lxw111110/MyMiniFly/hardware/mini_fly/Project Outputs for mini_fly/four_axis_v1.xls

Item # | #Column Name Error:Manufacturer | #Column Name Error:Manufacturer No | Quantity | #Column Name Error:Note | Designator | Description | Footprint | Comment | LibRef
1 |  |  | 1 |  | C1 |  | 0603P | 2.2pf | C
2 |  |  | 1 |  | C2 |  | 0603P | 2.2nf | C
3 |  |  | 1 |  | C3 |  | 0603P | 0.047uf | C
4 |  |  | 7 |  | C4, C13, C18, C19, C22, C27, C30 |  | 0603P | 10uF | C
5 |  |  | 3 |  | C5, C21, C28 |  | 0603P | 10nf | C
6 |  |  | 1 |  | C6 |  | 0603P | 220pf | C
7 |  |  | 13 |  | C7, C11, C12, C14, C15, C16, C17, C20, C23, C24, C29, C31, C32 |  | 0603P | 0.1uf | C
8 |  |  | 2 |  | C8, C9 |  | 0603P | 12pf | C
9 |  |  | 2 |  | C10, C26 |  | 0603P | 1uF | C
10 |  |  | 1 |  | C25 |  | C0805 钽电容 | 22uF | CAP
11 |  |  | 2 |  | D1, D2 | LED 1206 侧贴 双色 | LED1206 侧贴 | LED-RG | LED 1206 侧贴 双色
12 |  |  | 2 |  | D3, D4 | LED 1206 侧贴 单色 | LED1206 侧贴 | LED-B | LED 1206 侧贴 单色
13 |  |  | 4 |  | D5, D6, D7, D8 | 单肖特基二极管 | SOD-323 | BAT54WS | BAT54
14 |  |  | 1 |  | L1 |  | 0603P | 3.9nH | L
15 |  |  | 1 |  | L2 |  | 0603P | 1nH | L
16 |  |  | 1 |  | L3 |  | 0603P | 1uH | L
17 |  |  | 4 |  | MOS1, MOS2, MOS3, MOS4 | AP2306 | SO-G3/C2.5 | SI2302 | MOS-N
18 |  |  | 1 |  | P1 |  | SH1.0-6P | STM_SWD | HEAD6
19 |  |  | 1 |  | P2 |  | HEADER8-2.0MM | CONN_8_RIGHT | HEAD8
20 |  |  | 1 |  | P3 |  | HEADER8-2.0MM | CONN_8_LEFT | HEAD8
21 |  |  | 1 |  | P4 | Header, 2-Pin | HDR1X2 | Battery | Header 2
22 |  |  | 1 |  | P5 |  | MICRO_USB5P_SOP | MICRO-USB | USB5
23 |  |  | 4 |  | P6, P7, P8, P9 |  | HEADER2-1.25MM | HEAD2 | HEAD2
24 |  |  | 5 |  | R1, R2, R3, R4, R28 |  | 0402 | 51R | R
25 |  |  | 2 |  | R5, R6 |  | 0402 | 1K | R
26 |  |  | 7 |  | R7, R8, R11, R12, R17, R21, R23 |  | 0402 | 10K | R
27 |  |  | 4 |  | R9, R10, R20, R22 |  | 0402 | 100R | R
28 |  |  | 5 |  | R13, R18, R19, R25, R26 |  | 0402 | 4.7K | R
29 |  |  | 1 |  | R14 |  | 0402 | 0R | R
30 |  |  | 2 |  | R15, R16 |  | 0402 | 49.9K | R
31 |  |  | 1 |  | R24 |  | 0402 | 510R | R
32 |  |  | 1 |  | R27 |  | 0402 | 100K | R
33 |  |  | 1 |  | R29 |  | 0402 | 1.6K | R
34 |  |  | 1 |  | SW1 |  | KEY_2S | SW_PUSH | KEY
35 |  |  | 1 |  | U1 |  | QFN16M | RFX2401C | RFX2401C
36 |  |  | 1 |  | U2 |  | 0603-6 | 2450BM14A0002 | BALUN
37 |  |  | 1 |  | U3 |  | QFN48M-04 | NRF51822 | NRF51822
38 |  |  | 2 |  | U4, U6 |  | SOT23-5S | XC6204-30 | XC6204
39 |  |  | 1 |  | U5 | STM32411xC_xE | UFQFPN48 | STM32411CE | STM32F411xC_xE
40 |  |  | 1 |  | U7 | TP4059 | SOT23-6S | TP4059 | TP4059
41 |  |  | 1 |  | U8 |  | LGA-8 | BMP280 | BMP280
42 |  |  | 1 |  | U9 |  | QFN24-0.4 | MPU9250 | MPU9250
43 |  |  | 1 |  | X1 | 无源贴片晶振 | XTAL3225 无源 | 16MHz | XTAL-无源贴片
44 |  |  | 1 |  | X2 |  | XTAL3215 | 8MHz | XTAL-3215
45 |  |  | 1 |  | Y1 |  | 1206 | 2450AT18B100 | CHIP_ANTENNA
