lxw111110/MyMiniFly/structure/装配体2.SLDASM

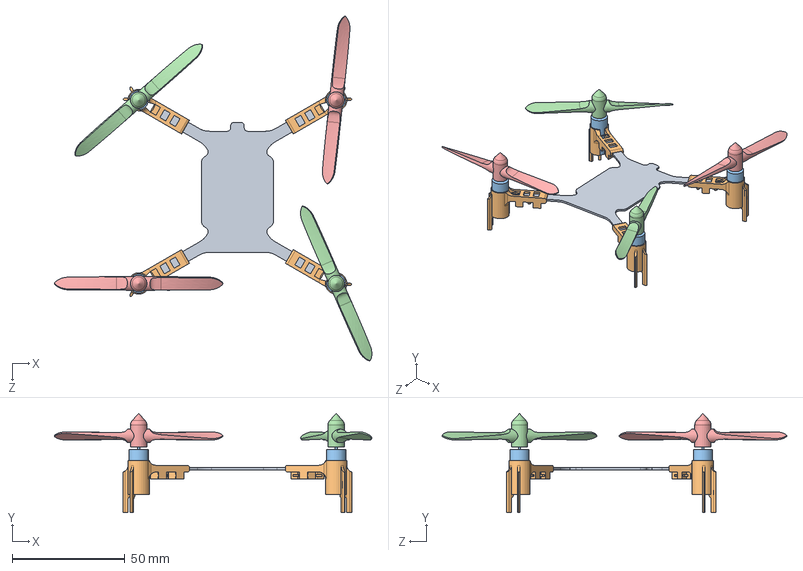
[picture p37: CAD file, 2018-09-06]
structure/装配体2.SLDASM
140.9 x 44.0 x 153.0 mm
airplane
支架 x 4
820电机 x 4
反浆 x 2
正浆 x 2
