lxw111110/MyMiniFly/structure/遥控器主板.SLDPRT

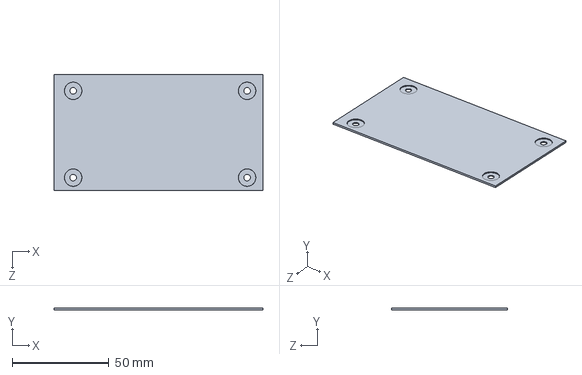
[picture p38: CAD file, 2018-10-11]
structure/遥控器主板.SLDPRT
108.0 x 1.00 x 60.0 mm
