lxw111110/MyMiniFly/structure/正浆.SLDPRT

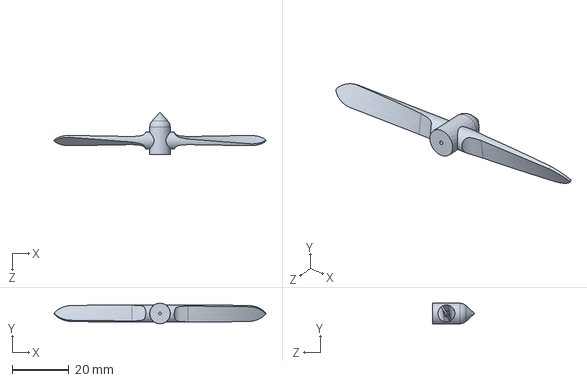
[picture p39: CAD file, 2018-09-06]
structure/正浆.SLDPRT
75.0 x 7.30 x 15.0 mm
