lxw111110/MyMiniFly/structure/airplane v1.0.DXF

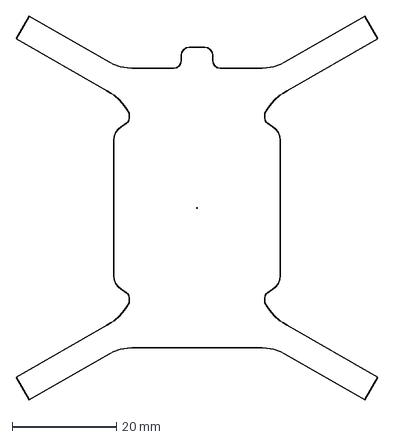
[picture p40: CAD file, 2018-09-06]
structure/airplane v1.0.DXF
69.3 x 73.7 mm
