lxw111110/MyMiniFly/structure/airplane.SLDPRT

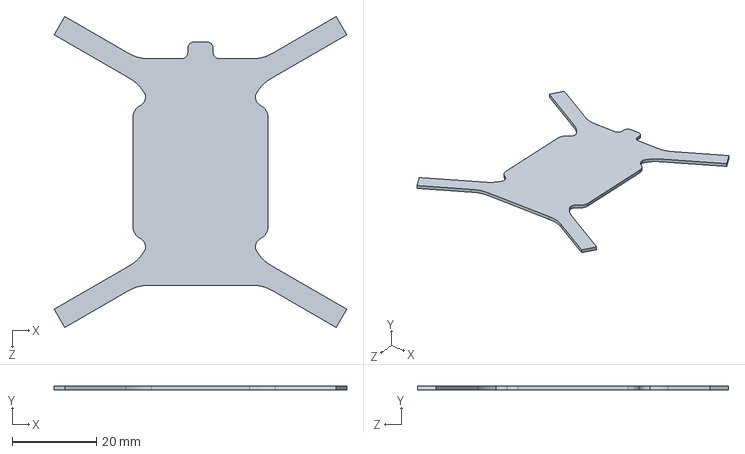
[picture p41: CAD file, 2018-09-06]
structure/airplane.SLDPRT
69.3 x 1.00 x 73.7 mm
