lxw111110/MyMiniFly/structure/支架.SLDPRT

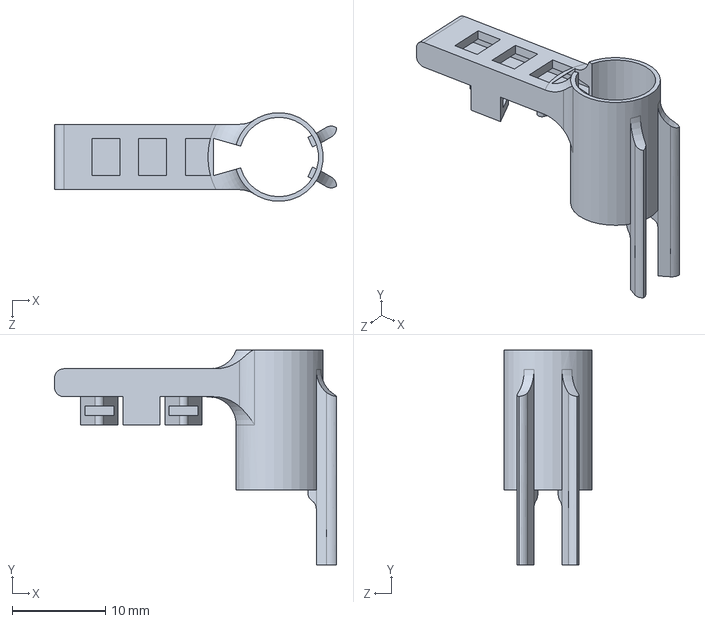
[picture p42: CAD file, 2018-09-06]
structure/支架.SLDPRT
30.2 x 23.0 x 9.46 mm
