lxw111110/MyMiniFly/structure/820电机.SLDPRT

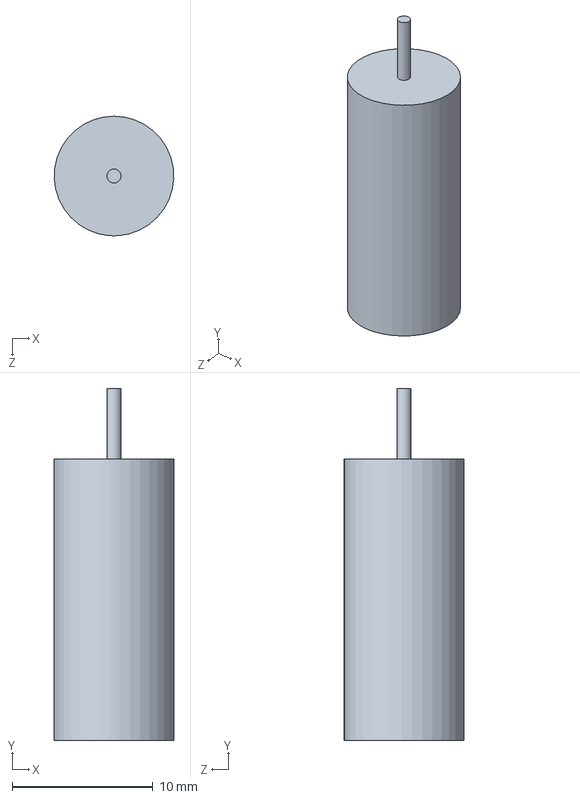
[picture p43: CAD file, 2018-09-06]
structure/820电机.SLDPRT
8.49 x 25.0 x 8.50 mm
