lxw111110/MyMiniFly/(list of files, cad)

Other CAD files:
structure/反浆.SLDPRT
structure/旋翼.SLDPRT
