lxw111110/MyMiniFly/doc/MiniFly V1.32.pdf

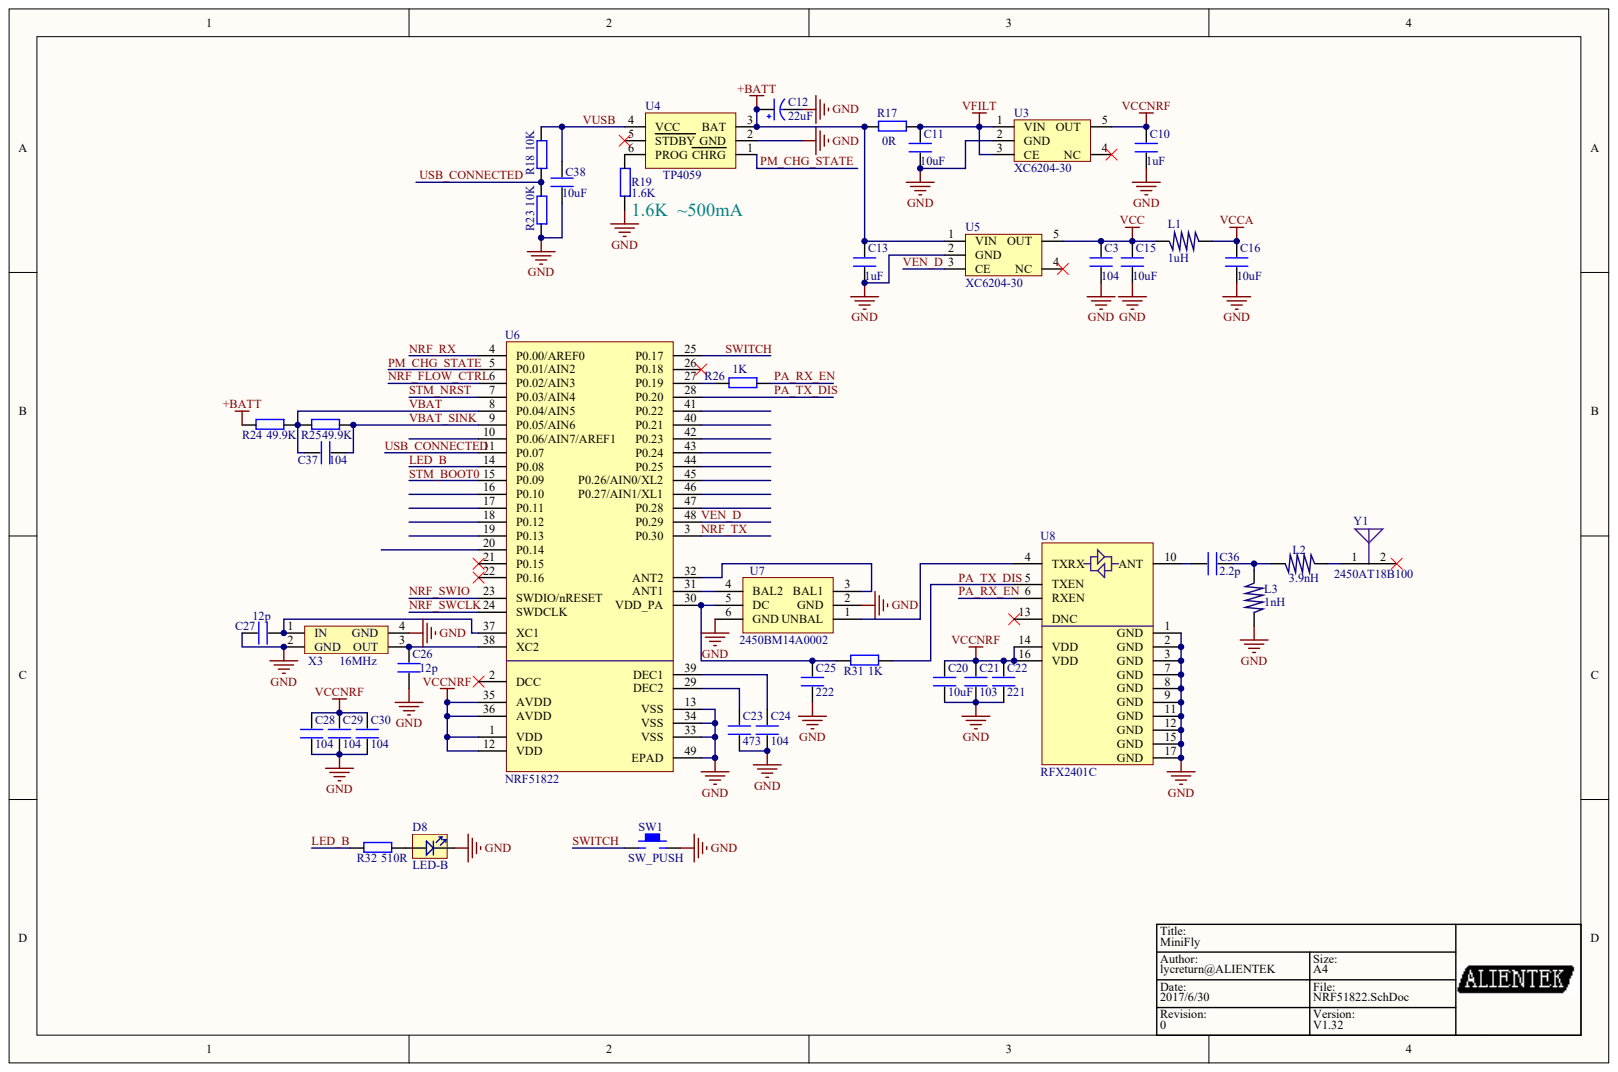
[picture p44: page 1]

PROG 6 | 10uF

PM_CHG_STATE

P0.05/AIN6 9
P0.06/AIN7/AREF1 10

TXRX 4

PA_RX_EN GND | RXEN 6 DNC 13

GND 6

VCCNRF

Title: MiniFly

Author: lycreturn@ALIENTEK | Size: A4

Date: 2017/6/30 | File: NRF51822.SchDoc

Revision: 0 | Version: V1.32

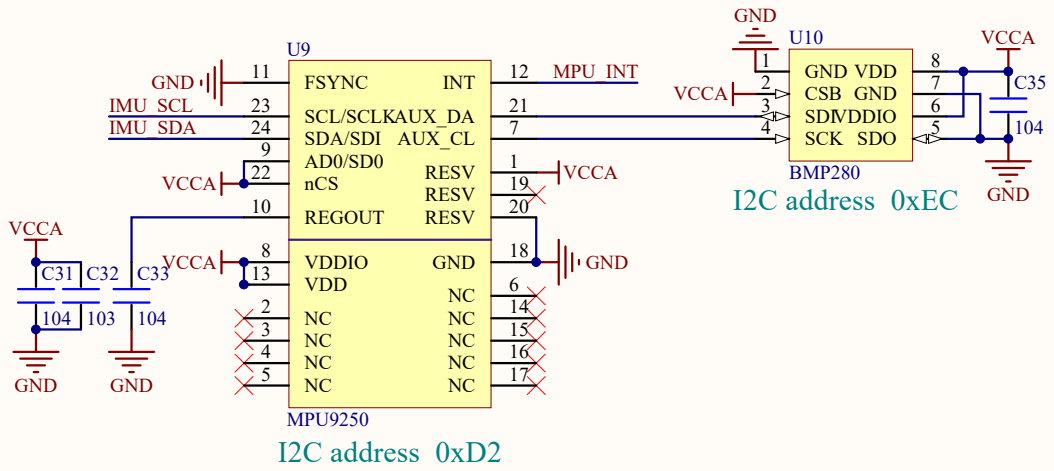
[picture p45: page 2]

Title : MiniFly

Author: lycreturn@ALIENTEK | Size: A4

Date : 2017/6/30 0 | File: SENSORS.SchDoc

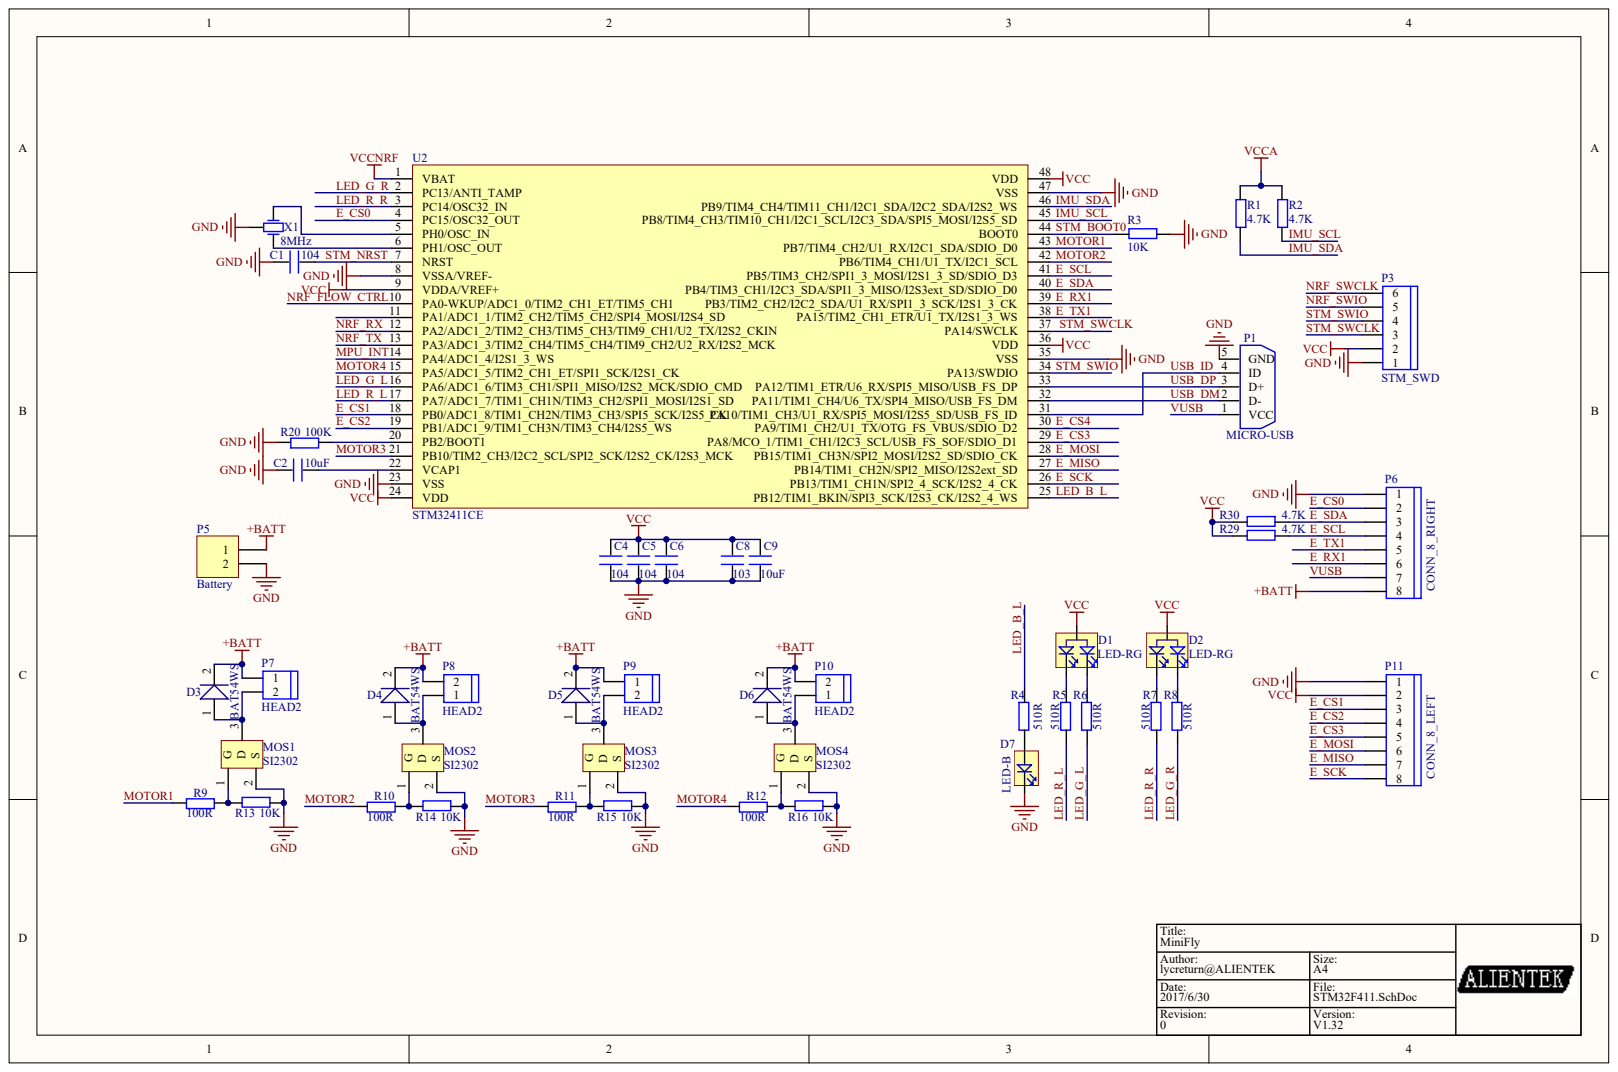
[picture p46: page 3]

E_CS0 | 4 | IMU_SCL

5 | STM_BOOT0R3

8MHz 6 | | MOTOR1

PA6/ADC1_6/TIM3_CH1/SPI1_MISO/I2S2_MCK/SDIO_CMD 16 | USB_DP
PA7/ADC1_7/TIM1_CH1N/TIM3_CH2/SPI1_MOSI/I2S1_SD 17 | USB_DM
PB0/ADC1_8/TIM1_CH2N/TIM3_CH3/SPI5_SCK/I2S5_CK 18 | VUS B

Title : MiniFly

Author: lycreturn@ALIENTEK | Size: A4

Date : 2017/6/30 0 | File: STM32F411.SchDoc

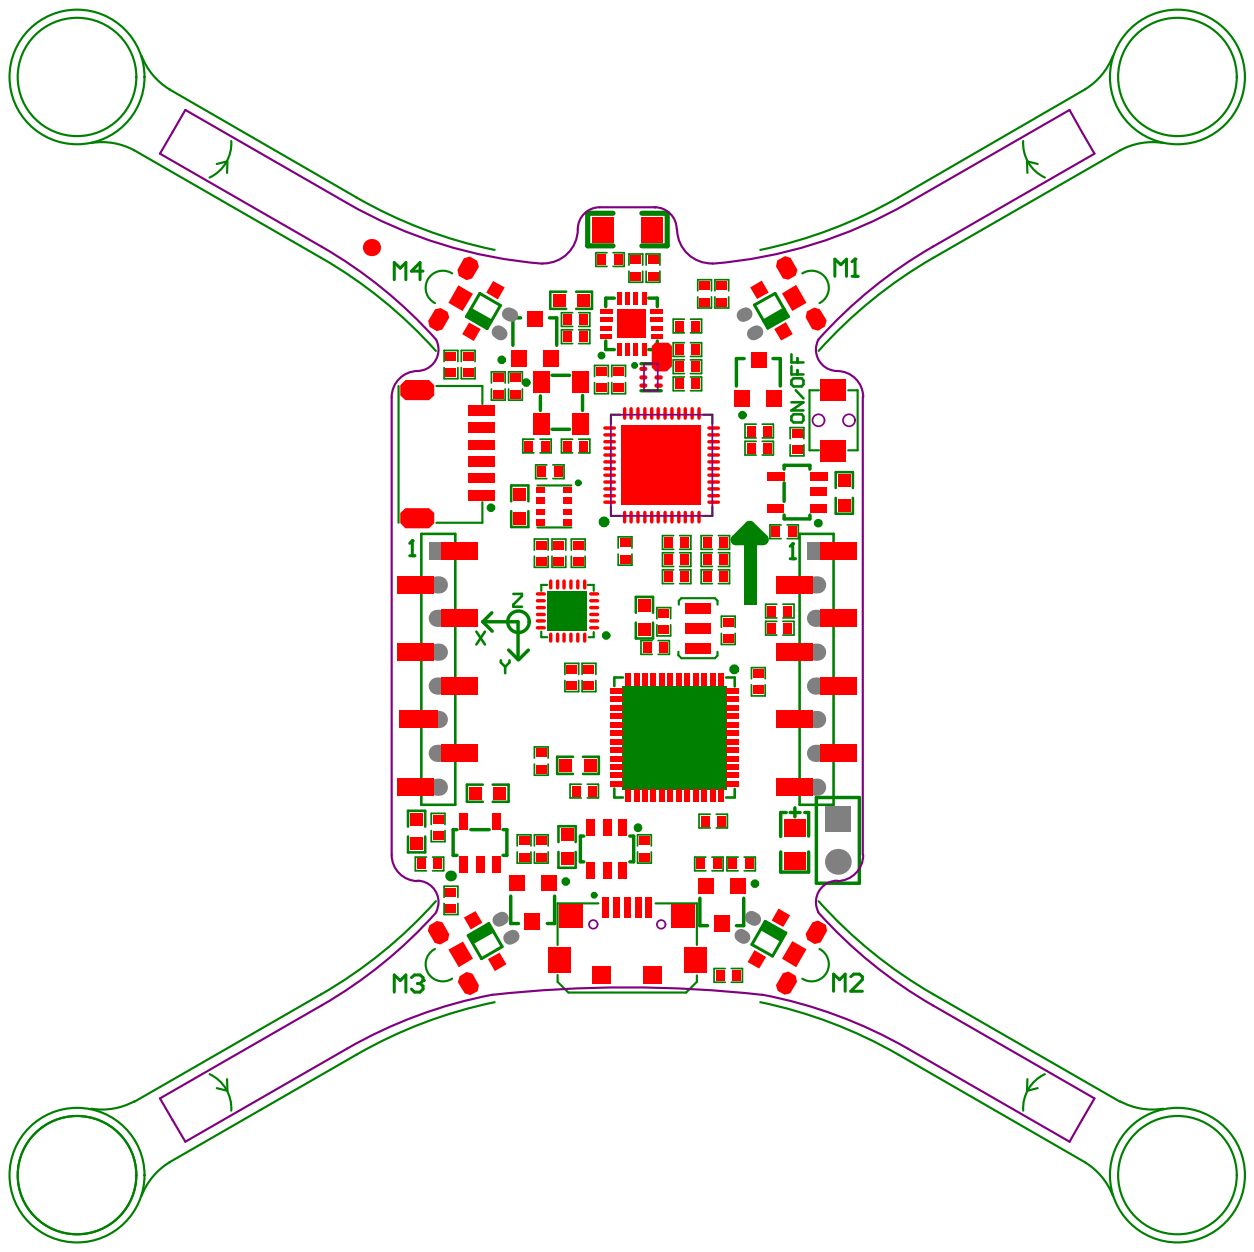
[picture p47: page 4]
