lxw111110/MyMiniFly/(list of files, drawings)

Other design files:
hardware/mini_fly/four_axis_part1.SchDoc
hardware/mini_fly/four_axis_part2.SchDoc
hardware/mini_fly/four_axis_part3.SchDoc
hardware/mini_fly/mini_fly.PrjPcb
