lxw111110/MyMiniFly/(commit log)

2018-09-06 MyMiniFly 基础结构与硬件文件
    [820电机.SLDPRT, airplane v1.0.DXF, airplane.SLDPRT, four_axis_part1.SchDoc, four_axis_part2.SchDoc, four_axis_part3.SchDoc, mini_fly.PrjPcb, 反浆.SLDPRT]
2018-09-18 上传参考文档
2018-09-20 修改个别走线，LED改变驱动方式
    [four_axis_part1.SchDoc, four_axis_part2.SchDoc, four_axis_part3.SchDoc]
2018-09-21 增加了STM32复位上拉并修改LED驱动方式
    [four_axis_part1.SchDoc, four_axis_part3.SchDoc, mini_fly.PrjPcb]
2018-10-11 上传remoter资料
    [four_axis_part3.SchDoc, four_axis_v1.xls, four_axis_v1.xlsx, mini_fly.PrjPcb, 遥控器主板.SLDPRT]
